maker-community/VerdureBuddyRover/firmware/esp32c3_kb_motor/esp32c3_kb_motor.ino

/**
 * ESP32-C3 SuperMini 综合固件
 * ------------------------------------------------------------------
 *  功能:
 *    1. BQ27220 电池计量 (I2C)            -> 上位机查询电量
 *    2. DRV8833 双电机驱动 (PWM 调速)      -> 上位机命令控制
 *    3. BLE 蓝牙键盘 (HID)                -> 按键上报给手机/电脑
 *    4. 上位机串口协议 (行式文本, 参考 xiaozhi-esp32 atom-echos3r)
 *         - 命令: drive / forward / back / turn / stop / led / status / battery / key
 *         - 主动事件: EVT key k<n> DOWN|UP
 * ------------------------------------------------------------------
 *  依赖库 (Arduino IDE 库管理器):
 *    - kode_bq27220           (已安装, 你现有的 BQ27220 库)
 *    - HijelHID_BLEKeyboard   (BLE HID 键盘, 基于 NimBLE-Arduino)
 * ------------------------------------------------------------------
 *  硬件接线 (建议, 以实际为准):
 *    BQ27220   SDA -> GPIO5   SCL -> GPIO6   (3.3V / GND)
 *    DRV8833   电机A: AIN1 -> GPIO0  AIN2 -> GPIO1
 *              电机B: BIN1 -> GPIO4  BIN2 -> GPIO7
 *              逻辑侧 VCC=3.3V GND, VMOT 按电机电压单独供电
 *    按键 x1   GPIO10 (接 GND, 内部上拉) = 回车
 *    RGB5050   R -> GPIO2  G -> GPIO3  B -> GPIO9 (共阴接 GND)
 *    上位机     硬件串口 UART1: TX -> GPIO20, RX -> GPIO21 (115200 8N1)
 * ------------------------------------------------------------------
 */

#include <Arduino.h>
#include <Wire.h>
#include <BQ27220.h>
#include <HijelHID_BLEKeyboard.h>
#include <NimBLEDevice.h>

// ============== 配置区 ==============
// --- BQ27220 I2C ---
const int I2C_SDA = 5;
const int I2C_SCL = 6;
const uint8_t BQ_ADDR = 0x55;
const int CHARGE_THRESHOLD_MA = 30;   // 判定充/放电的电流阈值 (mA)

// --- DRV8833 双电机 (2 输入脚/路, analogWrite 0~255) ---
const int AIN1 = 0, AIN2 = 1;         // 电机A
const int BIN1 = 4, BIN2 = 7;         // 电机B
const int DEFAULT_DRIVE_SPEED_PERCENT = 100;
const int DEFAULT_DRIVE_SPEED_LIMIT_PERCENT = 100; // 默认底盘动作限速
const unsigned long MOTOR_DIRECTION_DEADTIME_MS = 20;
const uint32_t MOTOR_PWM_FREQUENCY = 15000;
const uint8_t PWM_RESOLUTION_BITS = 8;
const uint8_t MOTOR_PWM_CHANNELS[2] = {0, 1};

// --- 按键 -> BLE 键盘码 (HID Usage ID), 现在只保留 1 个 = 回车 ---
const int NUM_KEYS = 1;
const uint8_t BUTTON_PINS[NUM_KEYS] = {10};
// HID 键盘 Usage ID: 0x28 = 回车
const uint8_t KEY_HID[NUM_KEYS] = {0x28};
const unsigned long DEBOUNCE_MS = 50;

// --- RGB5050 三色 LED (共阴 -> GND, analogWrite 0~255 调亮度) ---
const int RGB_R = 2, RGB_G = 3, RGB_B = 9;
const uint8_t RGB_PWM_CHANNELS[3] = {2, 3, 4};
const uint32_t RGB_PWM_FREQUENCY = 1000;
uint8_t rgbVal[3] = {0, 0, 0};        // 当前 RGB (0-255)
enum LedMode { LED_OFF, LED_SOLID, LED_BREATHE, LED_BLINK };
LedMode ledMode = LED_OFF;
unsigned long ledPeriodMs = 1600;
unsigned long ledPatternStarted = 0;

// --- 上位机串口 (硬件 UART1, 不用 USB CDC) ---
const unsigned long BAUD = 115200;
const int UART_TX = 20, UART_RX = 21;
const unsigned long BATTERY_REPORT_MS = 5000;  // 主动上报电量周期
const unsigned long BLE_HEALTH_CHECK_MS = 1000;
// ==================================

const char BLE_DEVICE_NAME[] = "Verdure Buddy Rover";

BQ27220 battery;
HijelHID_BLEKeyboard bleKb(BLE_DEVICE_NAME, "Verdure", 100);

// 运行状态
bool keyState[NUM_KEYS] = {false};        // 当前稳定按键状态
bool debState[NUM_KEYS] = {false};        // 去抖中间状态
unsigned long debTime[NUM_KEYS] = {0};
int motorSpeed[2] = {0, 0};               // 当前电机速度 -255..255
int motorPwmPin[2] = {AIN1, BIN1};
int driveSpeedLimitPercent = DEFAULT_DRIVE_SPEED_LIMIT_PERCENT;

struct StreamInput {
  char buffer[128];
  int length = 0;
};

StreamInput usbInput;
StreamInput uartInput;
unsigned long lastBatteryReport = 0;
unsigned long lastBleHealthCheck = 0;

// ---------- BLE 键盘后端适配 ----------
bool bleAdvertisingActive() {
  if (!NimBLEDevice::isInitialized()) return false;
  NimBLEAdvertising* advertising = NimBLEDevice::getAdvertising();
  return advertising != nullptr && advertising->isAdvertising();
}

bool ensureBleAdvertising() {
  delay(50);
  if (bleAdvertisingActive()) return true;

  Serial.println("WARN BLE advertising inactive, retrying...");
  if (!NimBLEDevice::startAdvertising()) {
    Serial.println("ERR BLE advertising retry failed");
    return false;
  }
  delay(50);
  return bleAdvertisingActive();
}

void bleKeyboardBegin() {
  bleKb.setLogLevel(HIDLogLevel::Normal);
  Serial.printf("BLE keyboard starting as %s...\r\n", BLE_DEVICE_NAME);
  bleKb.begin();
  Serial.printf("BLE advertising active=%d\r\n", ensureBleAdvertising() ? 1 : 0);
}

bool bleKeyboardReady() {
  return bleKb.isPaired();
}

void bleKeyboardTap(uint8_t key) {
  bleKb.tap(key);
}

// ---------- 电机 ----------
bool drivePwm(int id, int speed) {   // speed -255..255
  int p1 = id == 0 ? AIN1 : BIN1;
  int p2 = id == 0 ? AIN2 : BIN2;
  int activePin = speed < 0 ? p2 : p1;
  int inactivePin = speed < 0 ? p1 : p2;
  uint8_t channel = MOTOR_PWM_CHANNELS[id];

  if (speed == 0) {
    return ledcWriteChannel(channel, 0);
  }

  if (motorPwmPin[id] != activePin) {
    ledcWriteChannel(channel, 0);
    ledcDetach(motorPwmPin[id]);
    pinMode(motorPwmPin[id], OUTPUT);
    digitalWrite(motorPwmPin[id], LOW);
    pinMode(inactivePin, OUTPUT);
    digitalWrite(inactivePin, LOW);
    if (!ledcAttachChannel(activePin, MOTOR_PWM_FREQUENCY, PWM_RESOLUTION_BITS, channel)) {
      Serial.printf("ERR motor %d PWM attach failed on GPIO%d\r\n", id, activePin);
      Serial1.printf("ERR motor %d PWM attach failed on GPIO%d\r\n", id, activePin);
      return false;
    }
    motorPwmPin[id] = activePin;
  }

  return ledcWriteChannel(channel, abs(speed));
}

void setMotor(int id, int speed) {
  if (speed > 255) speed = 255;
  if (speed < -255) speed = -255;
  if (id < 0 || id > 1) return;
  if ((motorSpeed[id] > 0 && speed < 0) || (motorSpeed[id] < 0 && speed > 0)) {
    drivePwm(id, 0);
    delay(MOTOR_DIRECTION_DEADTIME_MS);
  }
  if (drivePwm(id, speed)) motorSpeed[id] = speed;
}

void setDrive(int left, int right) {
  left = constrain(left, -255, 255);
  right = constrain(right, -255, 255);
  setMotor(0, left);
  setMotor(1, right);
}

int limitDriveSpeed(int speed) {
  return constrain(speed, -driveSpeedLimitPercent, driveSpeedLimitPercent);
}

int percentToPwm(int percent) {
  return percent * 255 / 100;
}

// ---------- RGB5050 三色 LED (共阴) ----------
void applyRgb(int r, int g, int b) {
  ledcWriteChannel(RGB_PWM_CHANNELS[0], r);
  ledcWriteChannel(RGB_PWM_CHANNELS[1], g);
  ledcWriteChannel(RGB_PWM_CHANNELS[2], b);
}

void setRgb(int r, int g, int b) {
  if (r < 0) r = 0; if (r > 255) r = 255;
  if (g < 0) g = 0; if (g > 255) g = 255;
  if (b < 0) b = 0; if (b > 255) b = 255;
  rgbVal[0] = r; rgbVal[1] = g; rgbVal[2] = b;
  ledMode = r == 0 && g == 0 && b == 0 ? LED_OFF : LED_SOLID;
  ledPatternStarted = millis();
  applyRgb(r, g, b);
}

void setLedPattern(LedMode mode, int r, int g, int b, unsigned long periodMs) {
  if (r < 0) r = 0; if (r > 255) r = 255;
  if (g < 0) g = 0; if (g > 255) g = 255;
  if (b < 0) b = 0; if (b > 255) b = 255;
  rgbVal[0] = r; rgbVal[1] = g; rgbVal[2] = b;
  ledMode = mode;
  ledPeriodMs = constrain(periodMs, 200UL, 10000UL);
  ledPatternStarted = millis();
  applyRgb(r, g, b);
}

void updateLedPattern() {
  if (ledMode == LED_OFF || ledMode == LED_SOLID) return;
  unsigned long elapsed = millis() - ledPatternStarted;
  unsigned long phase = elapsed % ledPeriodMs;
  int brightness = 255;
  if (ledMode == LED_BLINK) {
    brightness = phase < ledPeriodMs / 2 ? 255 : 0;
  } else {
    unsigned long half = ledPeriodMs / 2;
    unsigned long triangle = phase < half ? phase : ledPeriodMs - phase;
    brightness = 20 + (int)(triangle * 235 / half);
  }
  applyRgb(rgbVal[0] * brightness / 255,
           rgbVal[1] * brightness / 255,
           rgbVal[2] * brightness / 255);
}

bool setLedEmotion(const String &emotion) {
  if (emotion == "off") setLedPattern(LED_OFF, 0, 0, 0, 1000);
  else if (emotion == "happy") setLedPattern(LED_BREATHE, 0, 255, 40, 1800);
  else if (emotion == "listening") setLedPattern(LED_BREATHE, 30, 100, 255, 1400);
  else if (emotion == "thinking") setLedPattern(LED_BREATHE, 180, 40, 255, 1200);
  else if (emotion == "charging") setLedPattern(LED_BREATHE, 0, 220, 255, 2000);
  else if (emotion == "warning") setLedPattern(LED_BLINK, 255, 120, 0, 700);
  else if (emotion == "error") setLedPattern(LED_BLINK, 255, 0, 0, 400);
  else if (emotion == "working") setLedPattern(LED_BREATHE, 255, 80, 0, 900);
  else return false;
  return true;
}

const char* ledModeName() {
  switch (ledMode) {
    case LED_SOLID: return "solid";
    case LED_BREATHE: return "breathe";
    case LED_BLINK: return "blink";
    default: return "off";
  }
}

// ---------- 按键: 单一数据源, 同时扇出到 串口 + BLE ----------
void setKeyState(int idx, bool pressed) {
  if (idx < 0 || idx >= NUM_KEYS || keyState[idx] == pressed) return;
  keyState[idx] = pressed;
  // 通路1: 串口上报 (UART1 上位机 + USB 调试都发)
  Serial.printf("EVT key k%d %s\r\n", idx + 1, pressed ? "DOWN" : "UP");
  Serial1.printf("EVT key k%d %s\r\n", idx + 1, pressed ? "DOWN" : "UP");
  // 实体按钮每次稳定按下只发送一次完整按键，避免松开沿丢失导致主机持续重复回车
  if (pressed && bleKeyboardReady()) bleKeyboardTap(KEY_HID[idx]);
}

void pollButtons() {
  for (int i = 0; i < NUM_KEYS; i++) {
    bool raw = !digitalRead(BUTTON_PINS[i]);   // INPUT_PULLUP, 按下=低
    if (raw != debState[i]) {
      debState[i] = raw;
      debTime[i] = millis();
    } else if (raw != keyState[i] && (millis() - debTime[i]) >= DEBOUNCE_MS) {
      setKeyState(i, raw);
    }
  }
}

// ---------- 电量 ----------
void readBattery(int &level, bool &charging, bool &discharging) {
  level = battery.readStateOfChargePercent();      // 0..100, -1 失败
  int ma = battery.readAverageCurrentMilliamps();  // INT16_MIN=-32768 失败
  if (level < 0) level = 0;
  charging = (ma > CHARGE_THRESHOLD_MA);
  discharging = (ma < -CHARGE_THRESHOLD_MA);
  if (ma == -32768) { charging = false; discharging = false; }
}

void reportBattery(Stream &s) {
  int level; bool chg, dchg;
  readBattery(level, chg, dchg);
  s.printf("battery level=%d charging=%d discharging=%d\r\n",
           level, chg ? 1 : 0, dchg ? 1 : 0);
}

void printStatusJson(Stream &s) {
  int level; bool chg, dchg;
  readBattery(level, chg, dchg);
  int mv = battery.readVoltageMillivolts();
  int ma = battery.readAverageCurrentMilliamps();
  if (mv < 0) mv = 0;
  if (ma == -32768) ma = 0;

  s.print("{\"battery\":{\"level\":"); s.print(level);
  s.print(",\"charging\":"); s.print(chg ? 1 : 0);
  s.print(",\"discharging\":"); s.print(dchg ? 1 : 0);
  s.print(",\"mv\":"); s.print(mv);
  s.print(",\"ma\":"); s.print(ma);
  s.print("},\"motor\":{\"m0\":"); s.print(pwmToPercent(motorSpeed[0]));
  s.print(",\"m1\":"); s.print(pwmToPercent(motorSpeed[1]));
  s.print("},\"keys\":{\"k1\":"); s.print(keyState[0] ? 1 : 0);
  s.print("},\"rgb\":["); s.print(rgbVal[0]); s.print(',');
  s.print(rgbVal[1]); s.print(','); s.print(rgbVal[2]);
  s.print("],\"led\":{\"mode\":\""); s.print(ledModeName());
  s.print("\",\"period_ms\":"); s.print(ledPeriodMs);
  s.print("},\"speed_limit\":"); s.print(driveSpeedLimitPercent);
  s.print(",\"ble\":{\"connected\":"); s.print(bleKeyboardReady() ? 1 : 0);
  s.println("}}");
}

void printHelp(Stream &s) {
  s.println("=== ESP32-C3 SuperMini (BQ27220 + DRV8833 + BLE KB) ===");
  s.println("Commands (case-insensitive):");
  s.println("  status                  - full status JSON (battery/motor/keys/rgb/ble)");
  s.println("  battery                 - battery only: level/charging/discharging");
  s.println("  ble                     - BLE connected/paired/bonded status");
  s.println("  ble restart             - restart BLE advertising");
  s.println("  ble clear               - clear bonds and restart advertising");
  s.println("  drive <left> <right>    - drive both motors, -100..100");
  s.println("  forward [speed]         - move forward, speed 0..100");
  s.println("  back [speed]            - move backward, speed 0..100");
  s.println("  turn|spin <left|right> [speed] - turn in place, limited by speed_limit");
  s.println("  limit <0-100>          - set drive speed limit percent");
  s.println("  stop                    - stop both motors");
  s.println("  motor <0|1> <fwd|rev|stop> [0-255] - low-level motor control");
  s.println("  key <1> <0|1>           - simulate button (debug, key1=Enter)");
  s.println("  led <on|off>            - turn white LED on/off");
  s.println("  led breathe <r> <g> <b> [ms] - breathing color");
  s.println("  led blink <r> <g> <b> [ms] - blinking color");
  s.println("  led emotion <name>      - happy/listening/thinking/charging/warning/error/working");
  s.println("  rgb <r> <g> <b>         - set RGB5050 color (0-255 each)");
  s.println("  ping                    - heartbeat");
  s.println("  help / ?                - this help");
}

// ---------- 串口命令处理 (行式, 参考 atom-echos3r.cc) ----------
bool parseSpeed(const String &arg, int defaultSpeed, int &speed) {
  String value = arg;
  value.trim();
  speed = value.length() == 0 ? defaultSpeed : value.toInt();
  return speed >= 0 && speed <= 100;
}

int pwmToPercent(int speed) {
  return speed * 100 / 255;
}

void sendDriveAck(Stream &out) {
  out.printf("OK drive left=%d right=%d\r\n", pwmToPercent(motorSpeed[0]),
             pwmToPercent(motorSpeed[1]));
}

void handleCommand(String &line, Stream &out) {
  line.trim();
  String cmd = line;
  String arg;
  int sp = line.indexOf(' ');
  if (sp >= 0) { arg = line.substring(sp + 1); cmd = line.substring(0, sp); }
  cmd.toLowerCase();

  if (cmd == "help" || cmd == "?") {
    printHelp(out);
  } else if (cmd == "ping") {
    out.println("OK ping");
  } else if (cmd == "status") {
    printStatusJson(out);
  } else if (cmd == "battery") {
    reportBattery(out);
  } else if (cmd == "ble") {
    String action = arg;
    action.trim();
    action.toLowerCase();
    if (action == "restart") {
      bleKb.end();
      delay(50);
      bleKb.begin();
      if (ensureBleAdvertising()) out.printf("OK ble advertising restarted name=%s\r\n", BLE_DEVICE_NAME);
      else out.println("ERR ble advertising restart failed");
    } else if (action == "clear") {
      bleKb.end();
      delay(50);
      bleKb.clearBonds();
      bleKb.begin();
      if (ensureBleAdvertising()) out.printf("OK ble bonds cleared; advertising restarted name=%s\r\n", BLE_DEVICE_NAME);
      else out.println("ERR ble bonds cleared but advertising restart failed");
    } else if (action.length() == 0 || action == "status") {
      out.printf("ble advertising=%d connected=%d paired=%d bonded=%d name=%s\r\n",
                 bleAdvertisingActive() ? 1 : 0, bleKb.isConnected() ? 1 : 0,
             bleKb.isPaired() ? 1 : 0, bleKb.isBonded() ? 1 : 0, BLE_DEVICE_NAME);
    } else {
      out.println("ERR ble usage: ble [status|restart|clear]");
    }
  } else if (cmd == "drive") {
    int left = 0, right = 0;
    if (sscanf(arg.c_str(), "%d %d", &left, &right) != 2 ||
        left < -100 || left > 100 || right < -100 || right > 100) {
      out.println("ERR drive usage: drive <-100..100> <-100..100>");
      return;
    }
    left = limitDriveSpeed(left);
    right = limitDriveSpeed(right);
    setDrive(percentToPwm(left), percentToPwm(right));
    sendDriveAck(out);
  } else if (cmd == "forward" || cmd == "back") {
    int speed = 0;
    if (!parseSpeed(arg, DEFAULT_DRIVE_SPEED_PERCENT, speed)) {
      out.println("ERR speed must be 0..100");
      return;
    }
    speed = limitDriveSpeed(speed);
    int value = percentToPwm(speed);
    if (cmd == "back") value = -value;
    setDrive(value, value);
    sendDriveAck(out);
  } else if (cmd == "turn" || cmd == "spin") {
    int separator = arg.indexOf(' ');
    String direction = separator < 0 ? arg : arg.substring(0, separator);
    String speedArg = separator < 0 ? String() : arg.substring(separator + 1);
    int speed = 0;
    direction.toLowerCase();
    if ((direction != "left" && direction != "right") ||
      !parseSpeed(speedArg, DEFAULT_DRIVE_SPEED_PERCENT, speed)) {
      out.println("ERR turn usage: turn <left|right> [0-100]");
      return;
    }
    speed = limitDriveSpeed(speed);
    int value = percentToPwm(speed);
    if (direction == "left") setDrive(-value, value);
    else setDrive(value, -value);
    sendDriveAck(out);
  } else if (cmd == "limit" || cmd == "speedlimit") {
    int limit = -1;
    if (sscanf(arg.c_str(), "%d", &limit) != 1 || limit < 0 || limit > 100) {
      out.println("ERR limit usage: limit <0-100>");
      return;
    }
    driveSpeedLimitPercent = limit;
    out.printf("OK limit=%d\r\n", driveSpeedLimitPercent);
  } else if (cmd == "stop") {
    setDrive(0, 0);
    sendDriveAck(out);
  } else if (cmd == "motor") {
    int id = -1, speed = 255;
    char dir[8] = {0};
    if (sscanf(arg.c_str(), "%d %s %d", &id, dir, &speed) < 2) {
      out.println("ERR motor usage: motor <0|1> <fwd|rev|stop> [0-255]");
      return;
    }
    if (id != 0 && id != 1) { out.println("ERR bad motor id"); return; }
    String d = String(dir); d.toLowerCase();
    speed = constrain(speed, 0, 255);
    if (d == "stop")        setMotor(id, 0);
    else if (d == "fwd")    setMotor(id, speed);
    else if (d == "rev")    setMotor(id, -speed);
    else { out.println("ERR bad motor dir"); return; }
    out.printf("OK motor %d pwm=%d\r\n", id, abs(motorSpeed[id]));
  } else if (cmd == "key") {
    int id = 0, st = 0;
    if (sscanf(arg.c_str(), "%d %d", &id, &st) == 2 && id == 1) {
      setKeyState(id - 1, st != 0);
      out.printf("OK key %d\r\n", id);
    } else {
      out.println("ERR key usage: key <1> <0|1>");
    }
  } else if (cmd == "led" || cmd == "light") {
    String mode = arg;
    mode.trim();
    mode.toLowerCase();
    if (mode.startsWith("emotion ")) {
      String emotion = mode.substring(8);
      emotion.trim();
      if (!setLedEmotion(emotion)) {
        out.println("ERR unknown emotion");
        return;
      }
      out.printf("OK led emotion=%s mode=%s\r\n", emotion.c_str(), ledModeName());
      return;
    }
    int separator = mode.indexOf(' ');
    String pattern = separator < 0 ? mode : mode.substring(0, separator);
    if (pattern == "breathe" || pattern == "blink") {
      int r = -1, g = -1, b = -1, period = 1600;
      String values = separator < 0 ? String() : mode.substring(separator + 1);
      int count = sscanf(values.c_str(), "%d %d %d %d", &r, &g, &b, &period);
      if (count < 3 || r < 0 || r > 255 || g < 0 || g > 255 || b < 0 || b > 255) {
        out.println("ERR led pattern usage: led breathe|blink <r> <g> <b> [ms]");
        return;
      }
      setLedPattern(pattern == "breathe" ? LED_BREATHE : LED_BLINK, r, g, b, period);
      out.printf("OK led mode=%s\r\n", pattern.c_str());
    } else if (mode == "off" || mode == "0") setRgb(0, 0, 0);
    else if (mode == "on" || mode == "1") setRgb(255, 255, 255);
    else {
      out.println("ERR led usage: led <on|off>");
      return;
    }
    out.printf("OK led state=%d\r\n", mode == "on" || mode == "1" ? 1 : 0);
  } else if (cmd == "rgb") {
    int r = -1, g = -1, b = -1;
    if (sscanf(arg.c_str(), "%d %d %d", &r, &g, &b) == 3) {
      setRgb(r, g, b);
      out.println("OK rgb");
    } else {
      out.println("ERR rgb usage: rgb <r> <g> <b> (0-255)");
    }
  } else {
    out.println("ERR unknown command (type help)");
  }
}

void processStream(Stream &s, StreamInput &input) {
  while (s.available()) {
    char c = s.read();
    if (c == '\n' || c == '\r') {
      if (input.length == 0) continue;
      input.buffer[input.length] = '\0';
      String line = String(input.buffer);
      input.length = 0;
      handleCommand(line, s);
    } else if (input.length < (int)sizeof(input.buffer) - 1) {
      input.buffer[input.length++] = c;
    } else if (input.length >= (int)sizeof(input.buffer) - 1) {
      input.length = 0;
      s.println("ERR line too long");
    }
  }
}

// ---------- setup / loop ----------
void setup() {
  Serial.begin(BAUD);                                   // USB CDC 仅调试
  Serial1.begin(BAUD, SERIAL_8N1, UART_RX, UART_TX);    // 上位机协议 (UART1)
  delay(100);                                           // 等待冷启动电源稳定

  // BLE 不依赖 USB 串口连接，优先初始化以保证冷启动即可广播
  bleKeyboardBegin();

  // I2C + BQ27220 (ESP32 需显式指定 SDA/SCL)
  Wire.begin(I2C_SDA, I2C_SCL);
  if (!battery.begin(Wire, BQ_ADDR, I2C_SDA, I2C_SCL, 400000)) {
    Serial.println("WARN BQ27220 init failed, check wiring");
  }

  // DRV8833
  pinMode(AIN1, OUTPUT); pinMode(AIN2, OUTPUT);
  pinMode(BIN1, OUTPUT); pinMode(BIN2, OUTPUT);
  digitalWrite(AIN1, LOW); digitalWrite(AIN2, LOW);
  digitalWrite(BIN1, LOW); digitalWrite(BIN2, LOW);
  if (!ledcAttachChannel(AIN1, MOTOR_PWM_FREQUENCY, PWM_RESOLUTION_BITS, MOTOR_PWM_CHANNELS[0]) ||
      !ledcAttachChannel(BIN1, MOTOR_PWM_FREQUENCY, PWM_RESOLUTION_BITS, MOTOR_PWM_CHANNELS[1])) {
    Serial.println("ERR motor PWM initialization failed");
  }
  ledcWriteChannel(MOTOR_PWM_CHANNELS[0], 0);
  ledcWriteChannel(MOTOR_PWM_CHANNELS[1], 0);

  // RGB5050 (共阴): 固定使用 3 个 LEDC 通道，避免 ESP32-C3 的 6 通道上限冲突
  if (!ledcAttachChannel(RGB_R, RGB_PWM_FREQUENCY, PWM_RESOLUTION_BITS, RGB_PWM_CHANNELS[0]) ||
      !ledcAttachChannel(RGB_G, RGB_PWM_FREQUENCY, PWM_RESOLUTION_BITS, RGB_PWM_CHANNELS[1]) ||
      !ledcAttachChannel(RGB_B, RGB_PWM_FREQUENCY, PWM_RESOLUTION_BITS, RGB_PWM_CHANNELS[2])) {
    Serial.println("ERR RGB PWM initialization failed");
  }
  setRgb(0, 0, 0);                                     // 默认熄灭

  // 按键 (内部上拉, 按下=低)
  for (int i = 0; i < NUM_KEYS; i++) pinMode(BUTTON_PINS[i], INPUT_PULLUP);

  Serial.println("READY");                 // USB 调试
  Serial1.println("READY");                // 上位机 UART
  printHelp(Serial);
  printHelp(Serial1);
}

void loop() {
  pollButtons();          // 按键 -> 串口 + BLE
  updateLedPattern();     // 非阻塞更新 RGB 情绪/动画
  processStream(Serial, usbInput);  // USB 调试口命令
  processStream(Serial1, uartInput); // 上位机 UART1 命令

  // 未连接且广播意外停止时自动恢复，不依赖打开 USB 串口触发复位
  if (millis() - lastBleHealthCheck >= BLE_HEALTH_CHECK_MS) {
    lastBleHealthCheck = millis();
    if (!bleKb.isConnected() && !bleAdvertisingActive()) ensureBleAdvertising();
  }

  // 周期主动上报电量
  if (millis() - lastBatteryReport >= BATTERY_REPORT_MS) {
    lastBatteryReport = millis();
    reportBattery(Serial);
  }
}
