maker-community/VerdureBuddyRover/(commit log)

2026-08-14 整合 ESP32-C3 固件和项目结构文档
2026-08-14 改用 NimBLE BLE 键盘库
2026-08-14 增加桌面小车运动与 RGB 情绪控制
2026-08-15 fix firmware motor and BLE controls
    [esp32c3_kb_motor.ino]
2026-08-15 fix ESP32-C3 motor PWM channel allocation
    [esp32c3_kb_motor.ino]
2026-08-15 fix BLE startup and button handling
    [esp32c3_kb_motor.ino]
2026-08-15 update default speed and BLE device name
2026-08-17 补充外壳说明与渲染图，清理编译示例中的用户名路径，添加上位机固件分支引用
